1fatgmc/HandCab/24-06-16 Wiring Large-Volt Meter-1.pdf

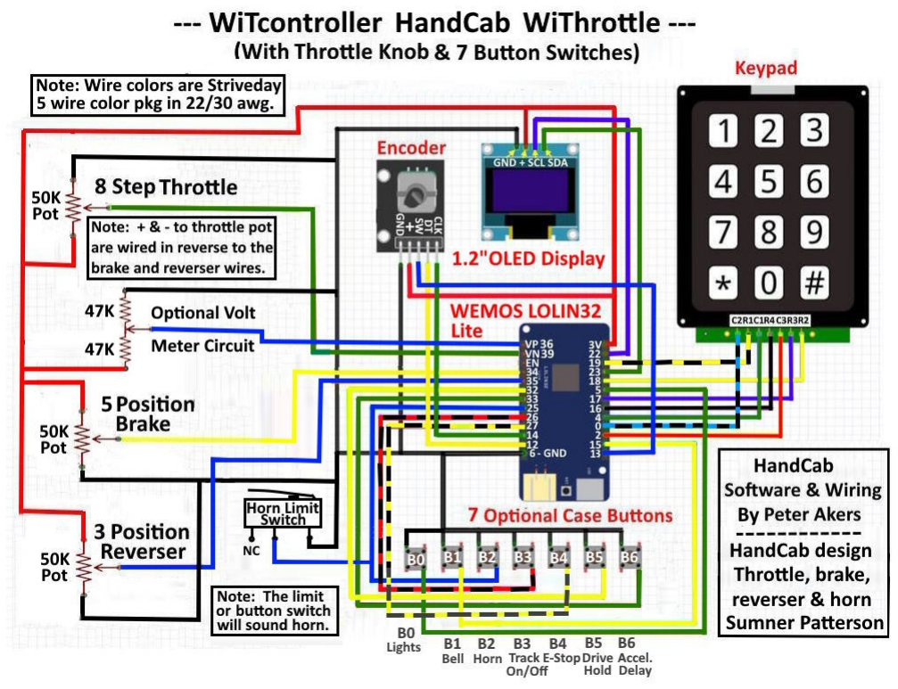
[picture p3: figure]
