1fatgmc/HandCab/actions.h

#define FUNCTION_NULL -1 // do nothing

#define FUNCTION_0 0 // lights
#define FUNCTION_1 1 // bell
#define FUNCTION_2 2 // horn
#define FUNCTION_3 3
#define FUNCTION_4 4
#define FUNCTION_5 5
#define FUNCTION_6 6
#define FUNCTION_7 7
#define FUNCTION_8 8
#define FUNCTION_9 9
#define FUNCTION_10 10
#define FUNCTION_11 11
#define FUNCTION_12 12
#define FUNCTION_13 13
#define FUNCTION_14 14
#define FUNCTION_15 15
#define FUNCTION_16 16
#define FUNCTION_17 17
#define FUNCTION_18 18
#define FUNCTION_19 19
#define FUNCTION_20 20
#define FUNCTION_21 21
#define FUNCTION_22 22
#define FUNCTION_23 23
#define FUNCTION_24 24
#define FUNCTION_25 25
#define FUNCTION_26 26
#define FUNCTION_27 27
#define FUNCTION_28 28
#define FUNCTION_29 29
#define FUNCTION_30 30
#define FUNCTION_31 31

#define E_STOP 35
#define SPEED_MULTIPLIER 36

#define E_STOP_CURRENT_LOCO 55

#define POWER_TOGGLE 501
#define POWER_ON 502
#define POWER_OFF 503

#define SHOW_HIDE_BATTERY 504   // the battery test must be enabled for this to have any effect

#define CUSTOM_1 521
#define CUSTOM_2 522
#define CUSTOM_3 523
#define CUSTOM_4 524
#define CUSTOM_5 525
#define CUSTOM_6 526
#define CUSTOM_7 527
