1fatgmc/HandCab/Read_Pot_Values/static.h

// default values if that are not specified in config.h

#ifndef THROTTLE_PIN
  #define THROTTLE_PIN 39;
#endif 
#ifndef BRAKE_PIN
  #define BRAKE_PIN 34;
#endif REVERSER_PIN
  #define REVERSER_PIN 35; 
  
#ifndef SERIAL_SPEED
  #define SERIAL_SPEED 9600
 #endif 
