1fatgmc/HandCab/Read_Pot_Values/config_example.h

// Define Pot connections and buttons:
 #define THROTTLE_PIN 39;   //ESP32 Pin for the Throttle pot.
 #define BRAKE_PIN 34;      //ESP32 Pin for the brake pot.
 #define REVERSER_PIN 35;    //ESP32 Pin for the reverser pot. 

 #define SERIAL_SPEED 9600
