1fatgmc/HandCab/(commit log)

2024-05-21 more gutting of the multi-throttle code
2024-05-26 basic support of the reverser pot
    [HandCab.ino, config_buttons_example.h, static.h]
2024-05-26 start of the brake pot support
2024-05-26 throttle pot no longer optional
    [HandCab.ino, config_buttons_example.h, static.h]
2024-05-28 fixes to the brake pot
    [HandCab.ino, config_buttons_example.h, static.h]
2024-05-29 added support for brake and neutral overriding the throttle setting
2024-05-29 change to need one less entry in BRAKE_POT_VALUES than BRAKE_DELAY_TIMES
2024-05-31 correct throttle behaviour
2024-05-31 bug fix for the last barke position
    [HandCab.ino]
2024-06-01 - bug fix brake position 6 [5]
    [HandCab.ino, static.h]
2024-06-02 Delete WiTcontroller - Optional Buttons - pinouts v0.1.png
    Wrong pinouts for HandCab
2024-06-02 Delete WiTcontroller - 4x4 keypad, Optional Buttons - pinouts v0.1.png
    Not right pinouts for HandCab
2024-06-02 Delete WiTcontroller - optional buttons v0.1.fzz
    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
    [WiTcontroller - optional buttons v0.1.fzz]
2024-06-02 Delete WiTcontroller - 4x4 keypad, Optional buttons v0.1.fzz
    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
    [WiTcontroller - 4x4 keypad, Optional buttons v0.1.fzz]
2024-06-02 Changed values
    added values
    [WiTcontroller v0.1.fzz]
2024-06-05 add support for the Battery test from WiTController
2024-06-16 MDNs version problem
    The latest versions of the ESP32 Board Library (3.0.0 and later) have renamed an attribute. The code has been modified to reflect this.
    [HandCab.ino, config_buttons_example.h, static.h]
2024-06-17 automated fix for the ESP32 Board Library problem
    [static.h]
2024-06-19 print files link added
2024-06-26 - Added dynamic (temporary) recalibration of the Reverser and Brake pots to the *92 menu
    [HandCab.ino, static.h]
2024-06-26 Added dynamic (temporary) recalibration of the 8 throttle pots to the *94 menu
2024-06-26 UI improvements for the Throttle Pot (temporary) recalibration
2024-06-27 remove some of the trace statements
2024-07-08 Bug fix for the ability to store the 'temporary' pot values to non-volatile memory
    [HandCab.ino, static.h]
2024-07-09 Added action ``SHOW_HIDE_BATTERY`` which can be assigned to any key or button
2024-07-11 Update 24-06-16 Wiring Large-Volt Meter-1.jpg
    new wiring diagram
2024-07-13 fixed bug where it would not reliably go into notch 8
    [HandCab.ino, config_buttons_example.h, static.h]
2024-07-14 added alternate calculation for the THROTTLE_POT_NOTCH_VALUES in Read_Pot_Values2
2024-07-29 fix for the EStop not working correctly
    - Fix for the EStop not working correctly
    - Added support for the additional logging options in the WiThrottleProtocol library.
    Now requires version 1.1.19 of the WiThrottleProtocol library.
    [HandCab.ino, config_buttons_example.h, static.h]
2024-08-02 Update README.md
    Pot wiring and positions when running sketch.
2024-08-02 Update README.md
    Pot wiring and Handle positions for sketch.
2024-08-05 added code to help work out the BATTERY_CONVERSION_FACTOR
2024-10-16 Transfer some fixes from WiTcontroller to Handcab
    - Now requires version 1.1.25 of the WiThrottleProtocol library.
    - Add define to enable or disable the heartbeat by default ``#define HEARTBEAT_ENABLED true``
    - New define added for if no response is received from the server in the specified period (milliseconds), shut down. MAX_HEARTBEAT_PERIOD default is 4 minutes = 240000
    [HandCab.ino, config_buttons_example.h, static.h]
2025-01-31 added optional linear throttle (instead of notches)
2025-03-01 Added optional define for ``COAST_DELAY_TIMES``
    - Added optional define for ``COAST_DELAY_TIMES`` separate from the ``ACCELLERATION_DELAY_TIMES``
    - Removed #define for ``WITCONTROLLER_DEBUG`` and replaced it with ``HABDCAB_DEBUG``
    - Reworking of the DEBUG_LEVEL code to reduce memory usage if not enabled
    [HandCab.ino, config_buttons_example.h, static.h]
2026-02-03 Bug fix for the consists where the locos are reversed
    - Bug fix for the consists where the locos are reversed
    - Option to release locos in consist/mu by the index rather than the Address. New optional ``#define DROP_LOCO_BY_INDEX true``
    [HandCab.ino, config_buttons_example.h, static.h]
